clementpouget/3D_optrode_holders/(list of files, cad)

Other CAD files:
optrode_holder_FLiCRE_v2.ipt
optrode_holder_maelle.ipt
